janpieterbaalder/4d-rubiks-real/opstelling 4d rubiks real/README.md

# Opstelling 4D Rubiks — 3D werkbank + speelbare digital twin

`hardware.html` is de **enige ingang**: één realistische 3D-werkplaats met zowel de **hardware**
op (geschatte) ware grootte op een werkbank (een ESP32-DevKitC met een 74AHCT125-levelshifter op
een breadboard met de 330Ω, een draadloze controller, voeding, schakelaar, zekering,
verdeelblokken 5V/GND met de 1000µF, en de 189-WS2812B-led-rig) als de **speelbare game** op die 189
leds — 7 kubussen (midden + 6 armen) van elk 27 matwitte kubusjes met een led erin. Klik een
onderdeel aan voor uitleg + bedrading (de camera vliegt erheen), of speel direct (klik een kubusje /
controller-widget / toetsenbord). Aangestuurd door dezelfde, wiskundig geverifieerde engine als de
game.

Weergave (`bench/stage.js`): fysiek gebaseerde materialen, een studio-reflectiekaart, zachte
schaduwen, HDR-bloom op de leds, gekleurd licht dat de cellen op het frame en de werkbank werpen,
en Neutral-tone-mapping (houdt de 8 spelkleuren verzadigd). Schaal: 1 eenheid = 4 cm. Onder
**Weergave → Kwaliteit** schakel je tussen *hoog* en *laag* (voor telefoons/oudere laptops).

Zie [PLAN.md](PLAN.md) voor het volledige plan en [BEDRADING.md](BEDRADING.md) voor de
bouwhandleiding (BOM, pin-voor-pin, stroombudget, led-volgorde).

## Starten

De pagina gebruikt ES-modules + Three.js (van een CDN), dus serveer de map even
lokaal (dubbelklikken op `hardware.html` werkt niet vanwege module-beveiliging):

```powershell
cd "<pad-naar-de-repo>\opstelling 4d rubiks real"
python serve.py
# open daarna http://localhost:8000/hardware.html in Edge (of Chrome)
```

`serve.py` is een dev-server die caching uitschakelt, zodat wijzigingen altijd direct
zichtbaar zijn na verversen (gewone `python -m http.server` kan oude JS uit de cache tonen).

(Three.js komt nu van internet; voor een offline versie kunnen we het later lokaal meeleveren.)

## Besturing

Coördinaten (as-native, gelijk aan de fysieke led-plaatsing `ORIENT` en de firmware):
x = links(−)/rechts(+), y = onder(−)/boven(+), z = achter(−)/voor(+).
Kubus 0 in het midden (−1..1), de 6 armkubussen op ±3.

Speel met de **controller-widget** rechtsboven (1-op-1 met de echte draadloze controller), met
het **toetsenbord**, of klik direct een ledje aan.

| PS3-controller | Toetsenbord | Actie |
| --- | --- | --- |
| **D-pad** ▲▼◀▶ | `W`/`S`/`A`/`D` | Verplaats de selectie in het grondvlak (achter/voor/links/rechts) |
| **R-stick** ▲ / ▼ | `I` / `K` | Verplaats naar de boven- / onder-kubus |
| **L-stick** ◀ / ▶ | `←` / `→` | Draairichting (−/+); houd vast en kies een vlak |
| **□ / ✕ / ○ / △** | `Z` / `X` / `C` / `V` | Vlak XY / YZ / XZ / grip (ribbe 180° of hoek ±120°) |
| **L-stick ●** (L3) | `Enter` | 4D-rotatie (op de centrale cel van een armkubus) |
| **R-stick ●** (R3) | `Backspace` | Zet terug (undo) |
| **SELECT / START** | `Shift+S` / `Shift+R` | Husselen / reset |
| Slepen / scroll | | Camera draaien / verschuiven / zoomen |

**Niets beweegt mechanisch** — een rotatie verandert alleen de kleuren van de ledjes. Per cel
gelden exact de zetten uit het spel: de 3 vlakdraaien (`XY/YZ/XZ` ±90°, bij armkubussen met `W`),
plus bij randcellen een **180°-flip** en bij hoekcellen een **±120°-spin**. Centrale cellen kennen
alleen de 4D-rotatie. Een vlak "armeer" je met een face-knop en voer je uit met een richting (of
andersom) — net als op de echte controller.

> ℹ️ **Let op bij de grip (180°-flip / ±120°-spin):** je selecteert weliswaar een rand- of
> hoek-cubie, maar de zet **roteert de hele cel** (alle 27 ledjes van die kubus) om de bijbehorende
> ribbe- of lichaamsdiagonaal. Dat is geen los-blokje-draai maar een geldige celrotatie: ze ligt in
> de 24-elementen rotatiegroep van de kubus (geverifieerd in `game/test/math.test.js`). De
> geselecteerde cubie bepaalt enkel *welke* as.

### Oriëntatie: een getrouwe (niet-getaperde) kopie van de game
Elke kubus staat **exact georiënteerd zoals de game de bijbehorende cel projecteert**
(`engine.ORIENT`, afgeleid uit de 4D→3D-`project()` en in `engine.test.js` gecontroleerd
tegen die formules). Cruciaal: de interne **W-as** (binnen↔buiten) van elke armkubus loopt
*radiaal* — de `w=−1`-laag wijst naar het midden en is dus zichtbaar. (Een eerdere versie
knoopte W aan de diepte-as, waardoor een binnenste-cel-draai alleen verborgen achterlagen
veranderde en het leek alsof er niets gebeurde.) Hierdoor matcht elke draai van elke cel de
game. De Arduino moet de leds in deze oriëntatie bedraden.

### Hoe je een draai *ziet* zonder dat er iets beweegt
Een draai is een **permutatie**: elke kleur verhuist van een bron-led naar een doel-led, en
die verhuizingen vormen kleine kringetjes (4-cycli bij 90°, 3-cycli bij hoek-spins/8e-cel,
2-cycli bij rand-flips). De sim leest die permutatie uit (`engine.placements()` vóór/na de
zet) en laat een **heldere golf langs elk kringetje in de draairichting lopen**, terwijl elke
led naar zijn nieuwe kleur overvloeit zodra de golf passeert; leds die niet meedraaien dimmen
even weg (spotlight). Zo lees je de draai — óók op een effen opgeloste kubus, waar geen enkele
kleur verandert. Alles is pure led-kleur + helderheid over tijd, dus **1-op-1 na te maken op
de WS2812-leds** (de Arduino voert exact dezelfde golf uit).

## Bestanden

| Bestand | Doel |
| --- | --- |
| `engine.js` | Geverifieerde 4D-engine: twists, grips (180°/120°), centreren, `placements()`/`ledState()` (189-led-uitlezing + permutatie), `ORIENT` (kubus-oriëntatie = game-projectie) |
| `engine.test.js` | 28 controles die bewijzen dat de engine-port klopt, incl. ORIENT == game-projectie (`node engine.test.js`) |
| `hardware.html` + `hardware.js` | **De enige ingang**: interactieve 3D-werkbank (klik elk onderdeel voor uitleg + bedrading, gekleurde draadjes + stroom-/data-animatie) **én** de speelbare game op de 189 leds (controller-widget + toetsenbord). `CONNECTIONS` = de bedradingstabel (single source of truth) |
| `bench/stage.js` · `bench/parts.js` · `bench/textures.js` | De realistische scène: renderer + belichting + werkplaats + post-processing · de onderdelen-modellen op ware grootte · procedurele texturen (geen afbeeldingsbestanden nodig) |
| `tools/smoke.mjs` | Headless browsertest van de werkbank: start zonder fouten, alle verbindingen getekend, rendert, toetsenbord-spel (husselen/draaien/undo), infopaneel, weergaveknoppen, iPhone 15 Pro |
| `tools/bench-audit.mjs` | Exacte controles voor de smoke test: geen draad (mét dikte) door een onderdeel, het breadboard, de mat, het werkbankblad of de rig; elke ESP32-pin, 74AHCT125-poot en elk draadeinde in de juiste breadboard-strook |
| `firmware/test/parity.test.mjs` | Bewijst dat de C++-engine (`tesseract_engine.h`) exact gelijk rekent aan `engine.js` (native gecompileerd, duizenden willekeurige zetten) |
| `BEDRADING.md` | Bouwhandleiding: BOM, pin-voor-pin tabel, stroombudget, led-volgorde, bouw-/testvolgorde |
| `firmware/esp32_bluepad32/esp32_bluepad32.ino` | **Aanbevolen rig-firmware**: ESP32 + draadloze controller via **Bluepad32** (ingebouwde Bluetooth, geen shield/dongle) — zie `firmware/esp32_bluepad32/README-esp32.md` |
| `firmware/tesseract_rig.ino` | Alternatieve rig-firmware (Mega): leds + **PS3-controller (PS3BT via USB Host Shield)** + draai-animatie |
| `firmware/tesseract_engine.h` | De 4D-engine in C++ (1-op-1 port van `engine.js`) — single source of truth voor de wiskunde + de led-soldeerkaart + `freeRam()` |
| `firmware/wokwi/sketch.ino` | Wokwi-logica-testbank (PS3-layout nagebootst: 2 sticks + D-pad + face-knoppen + OLED): zelfde engine/leds/besturing, want Wokwi kan geen draadloze controller simuleren — zie `firmware/wokwi/README-wokwi.md` |
| `serve.py` | Dev-server zonder caching |
| `preview-*.png` | Referentiebeelden (opgelost / gehusseld) |

## Eén omgeving: hardware + spel in één scène

`hardware.html` combineert de bedrading-werkbank én de speelbare digital twin in dezelfde
3D-scène (draait onder `python serve.py`). Klik onderdelen aan om de bedrading te begrijpen, of
speel meteen op de 189 led-meshes. Zie **[BEDRADING.md](BEDRADING.md)** voor de volledige
hardware-handleiding. Voor browser-logica-tests van de firmware zonder hardware: de
Wokwi-testbank in [`firmware/wokwi/`](firmware/wokwi/).

## Tests draaien

```powershell
node engine.test.js                 # 28 checks: engine.js == de game-projectie
node firmware/test/parity.test.mjs  # C++-firmware-engine == engine.js (vereist g++ of clang++)
node tools/smoke.mjs                # 3D-werkbank in headless Chromium (vereist: npm i playwright)
```

De game-tests (`game/test/*.test.js`) vereisen `jsdom` (`npm i jsdom`). Alles draait ook
automatisch in GitHub Actions (`.github/workflows/tests.yml`) bij elke push en pull request.
