janpieterbaalder/4d-rubiks-real/opstelling 4d rubiks real/hardware.html

4D Rubiks — 3D-werkbank
werkplaats, onderdelen en 189 leds worden opgebouwd…

4D Rubiks · hardware & bedrading + speelbare game ℹ️ Over 📋 Bedrading 🎮 Game Status: AAN Cel: midden 0 zetten · opgelost ✔

×

×

## 4D Rubiks — over deze installatie

Een fysieke 4D-rubikskubus als licht-installatie · 189 WS2812B-leds in 7 kubussen

### Wat is dit?

Eén 3D-scène met zowel de echte hardware (een ESP32 met ingebouwde Bluetooth, een 3,3V→5V-levelshifter op de datalijn, een draadloze controller, 5V-voeding, 330Ω-weerstand, 1000µF-condensator, aan/uit-schakelaar, inline 10A-zekering, verdeelblokken 5V/GND) als de speelbare game op diezelfde 189 led-meshes. De 7 kubussen (midden + 6 armen, elk 3×3×3 = 27 matwitte kubusjes met een led erin) staan met staven verbonden op een rond voetstuk — net als het Blender-3D-model. Alles staat op (geschatte) ware grootte op een werkbank: kubusjes van ~2 cm, het geheel ~50 cm hoog.

Niets beweegt mechanisch. Een "draai" verplaatst geen plastic: alleen de kleuren van de ledjes verschuiven (de cellen permuteren wiskundig). Een tesseract heeft 8 cellen; je bouwt er fysiek 7 — de 8e ("buitenste") is verborgen. Met een 4D-rotatie op de centrale cel van een arm haal je verborgen cellen in beeld: die kubus wordt logisch het midden.

### Hoe je een draai ziet

Een draai is een permutatie: elke kleur verhuist van led naar led in kleine kringetjes (4-cycli bij 90°, 3-cycli bij hoek-spins, 2-cycli bij rand-flips). Er loopt een heldere golf in de draairichting langs zo'n kring terwijl elke led naar z'n nieuwe kleur overvloeit; de rest dimt even weg. Zo lees je de draai af — óók op een effen opgeloste kubus. Puur led-kleur + helderheid, dus 1-op-1 na te maken op de echte WS2812-leds.

### Spelen

- Bewegen: D-pad / WASD (grondvlak) · R-stick ▲▼ / IK (boven/onder-kubus)
- Draaien: houd een richting (L-stick ◀▶ / ←→) en kies een vlak Z/X/C/V (XY/YZ/XZ/grip) — of andersom
- 4D-rotatie L3 / Enter · undo R3 / ⌫ · husselen SELECT / Shift+S · reset START / Shift+R
- Of klik een onderdeel aan voor uitleg + bedrading, of een ledje om een cel te kiezen. Sleep/scroll = camera.

### De hardware

Klik links op een onderdeel om te zien wat het is en hoe het is aangesloten (de gekleurde draden lichten dan op). De besturing is een draadloze controller (PS4/PS5/Xbox/8BitDo/Switch Pro, of een DS3) via de ingebouwde Bluetooth van de ESP32 (bibliotheek Bluepad32) — geen shield of dongle. De 189 leds hangen aan één datadraad (GPIO13, via een levelshifter + 330Ω) uit een aparte 5V-voeding met power-injectie. De volledige bouwhandleiding — onderdelenlijst, pin-voor-pin bedrading, stroombudget en led-volgorde — staat in de 📋 Bedrading-pagina (gerenderd uit BEDRADING.md).

### Firmware & testen zonder hardware

De geverifieerde 4D-engine draait 1-op-1 op de microcontroller (firmware/; aanbevolen: esp32_bluepad32/). Geen hardware bij de hand? In Wokwi draai je de échte ESP32-code tegen gesimuleerde WS2812-leds in de browser — de logica-testbank firmware/wokwi_esp32/sketch.ino (controller nagebootst met sticks + knoppen, want Wokwi kan geen draadloze controller simuleren) test de engine én de 189-led-adressering. Dat de C++-engine exact hetzelfde rekent als deze 3D-twin, bewijst firmware/test/parity.test.mjs. Open de Wokwi-testbank ↗ (https://wokwi.com/projects/467721462500426753)

### Links

- Bouwhandleiding & bedrading: 📋 Bedrading-pagina openen (gerenderd uit BEDRADING.md)
- Broncode: github.com/janpieterbaalder/4d-rubiks-real
- De originele 4D-game (meegeleverd in deze omgeving): spelen — via de tab 🎮 Game bovenin
- Wokwi-firmwaresimulatie (ESP32-testbank): de testbank draaien ↗ (https://wokwi.com/projects/467721462500426753)

Sleep = draaien · scrollwiel indrukken / rechts slepen = verschuiven · scroll = zoomen · klik een onderdeel (de camera vliegt erheen) · speel met de controller of toetsenbord (WASD/IK = bewegen, ←/→ + Z/X/C/V = draaien)

Onderdelen ▸

Weergave ▸

⚡ Stroom-animatie 🏷 Labels 🧵 Led-draad 📡 Stuur dataframe 👁 Reset camera 🎚 Kwaliteit

Zo speel je ▸

Bewegen — D-pad / WASD = grondvlak · R-stick / I·K = op/neer

Draaivlak — face-knoppen of Z X C V

Draairichting — L-stick ◄► of ← →

4D-rotatie — ● L-stick of Enter

Zet terug — ● R-stick of Backspace

Husselen / Reset — SELECT·⇧S / START·⇧R

Draden ▸

Acties 🧭 Reset 4D-zicht ⏻ Aan / Uit

▲ ◀ ▶ ▼

beweeg x,y · WASD

SELECT
husselen START
reset

V— ZXY CXZ XYZ

vlak kiezen + richting

◀ ●
4D ▶

draairichting ←/→ · ● = 4D (Enter)

▲ ●
undo ▼

omhoog/omlaag I/K · ● = undo (⌫)
