janpieterbaalder/4d-rubiks-real/4d rubiks 3d model/blender_renders/connectors_v2.png

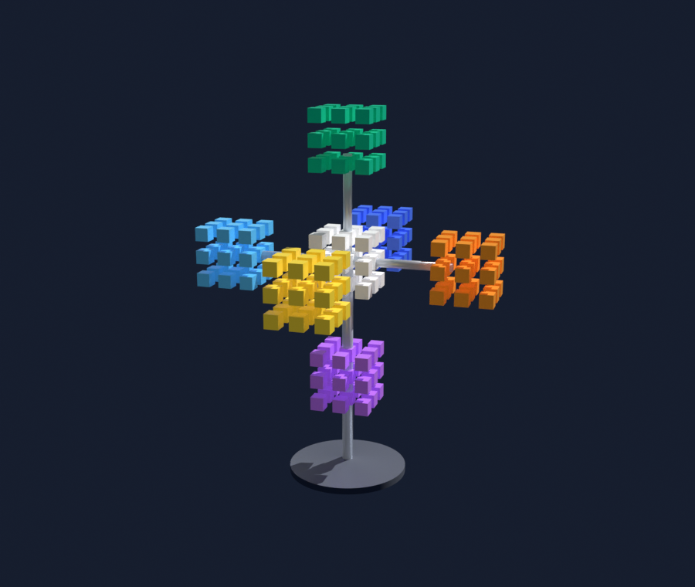
4d rubiks 3d model/blender_renders/connectors_v2.png
