janpieterbaalder/4d-rubiks-real/4d rubiks 3d model/blender_renders/tesseract_v5.png

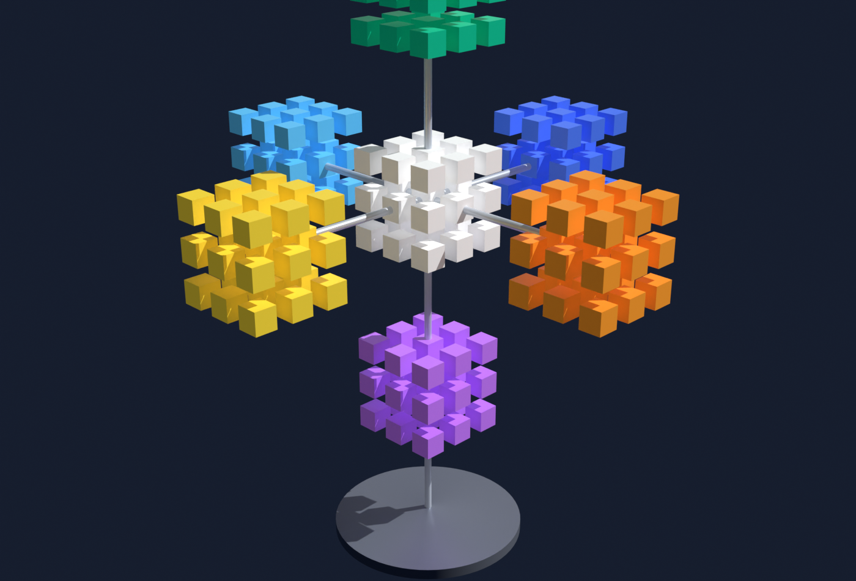
4d rubiks 3d model/blender_renders/tesseract_v5.png
