janpieterbaalder/4d-rubiks-real/opstelling 4d rubiks real/preview-gehusseld.png

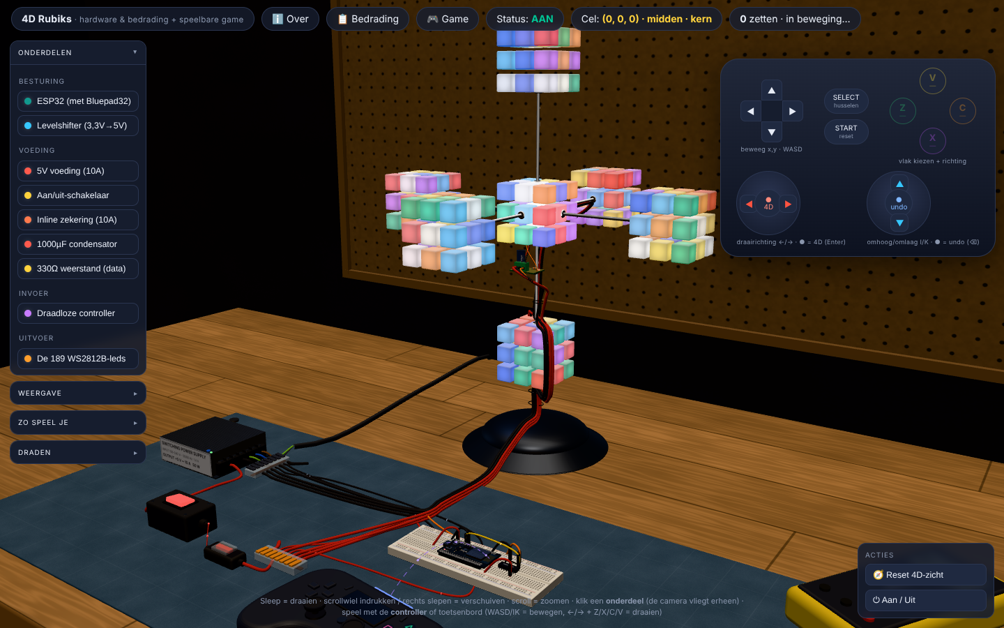
opstelling 4d rubiks real/preview-gehusseld.png
