janpieterbaalder/4d-rubiks-real/playstation controller/playstation controller besturing.png

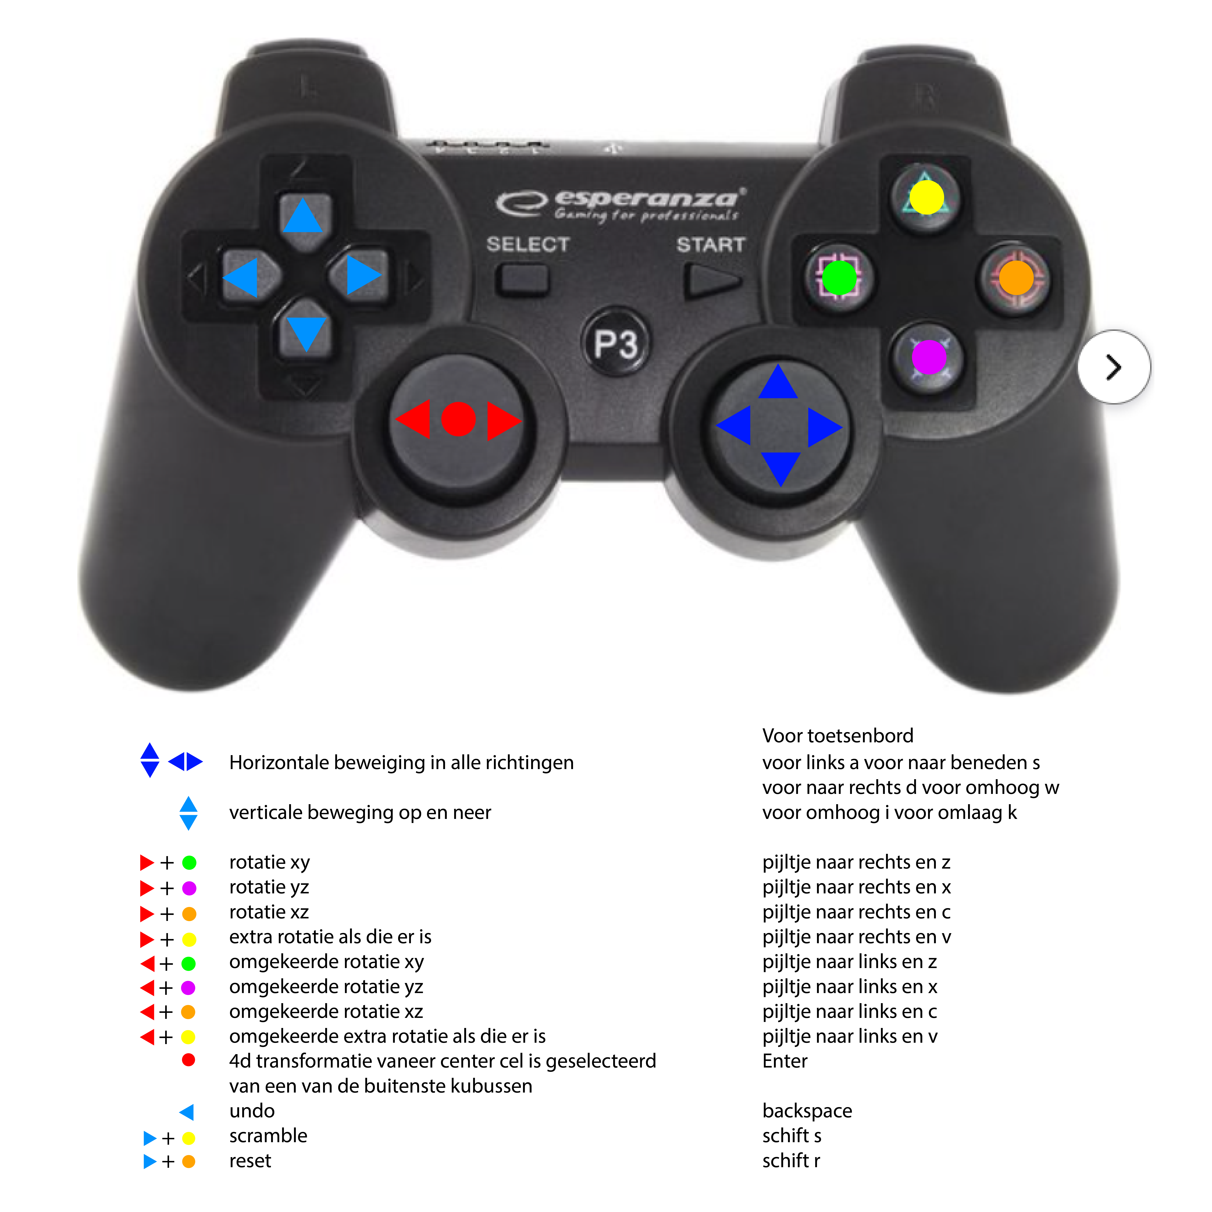
playstation controller/playstation controller besturing.png
