janpieterbaalder/4d-rubiks-real/(list of files, cad)

Other CAD files:
4d rubiks 3d model/4d rubiks 3d model.blend
