janpieterbaalder/4d-rubiks-real/(commit log)

2026-06-22 4D Rubiks LED-installatie: 3D-werkbank, PS3BT-firmware, bedrading en Blender-model
    - opstelling 4d rubiks real: hardware.html/js (3D-bench + speelbare twin op 189 leds),
    engine.js (+ 28 tests), firmware/tesseract_rig.ino (PS3BT) + tesseract_engine.h,
    BEDRADING.md, en de Wokwi-logica-testbank (firmware/wokwi/).
    - 4d rubiks 3d model: Blender-model (7 kubussen + verbindingsstaafjes + staander met
    ronde voet) en renders.
    - playstation controller: ontwerp-asset van de bediening.
    - hardware.html heeft een tab naar de online game (GitHub Pages).
    De originele Tesseract-game staat in een eigen repo (janpieterbaalder/tesseract-4d-rubiks-cube),
    gelinkt via de 'Online game'-tab; daarom hier niet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
    [4d rubiks 3d model.blend]
2026-06-23 Live 3D-omgeving op GitHub Pages + 'Over'-tab
    - root index.html: redirect naar de 3D-werkbank (opstelling .../hardware.html)
    - .nojekyll: Pages serveert de bestanden ongemoeid (mappen met spaties)
    - hardware.html: nieuwe 'ℹ️ Over'-tab met een uitleg-overlay (wat het is, besturing,
    hardware, links naar repo + online game) — voor live-bezoekers naast de README
2026-06-23 3D-omgeving: kubussen verbonden met staven + rond voetstuk; Over-tab uitgebreid
    - hardware.js: 6 verbindingsstaven (midden -> elke armkubus) + een pool die in een
    ronde voet (flared disc + domed top) uitkomt, zoals het Blender-model. Cache v=5.
    - hardware.html: 'ℹ️ Over'-overlay uitgebreid (wat is dit / 8e-cel-4D, hoe je een draai
    ziet, spelen, hardware, firmware + Wokwi-testbank) en een Wokwi-link toegevoegd.
2026-06-23 3D-omgeving: ook de pool van de voet naar de onderste kubus half zo dun (0.13 -> 0.065); cache v=7
2026-06-23 Game als code meegeleverd in de repo (niet langer een externe link)
    - opstelling 4d rubiks real/game/: de complete, speelbare 4D-Rubiks-game (Tesseract)
    gekopieerd uit de tesseract-4d-rubiks-cube-repo (index.html/app.js/styles.css/README/test).
    - hardware.html: de '🎮 Game'-tab opent nu de meegeleverde game (game/index.html) in
    dezelfde omgeving i.p.v. een externe Pages-link; Over-tab + README + .gitignore bijgewerkt.
2026-06-23 Game: '⟵ 3D-omgeving'-terugknop toegevoegd (terug naar hardware.html)
2026-06-23 Wokwi gelijk aan de rig + ESP32/Bluepad32-firmware + analysepunten (#1)
    * Wokwi gelijkgetrokken met de rig + analysepunten verwerkt
    Verbeterpunten uit de analyse aangepast (niets aan de geverifieerde
    engine/wiskunde gewijzigd; engine.test.js blijft 28/28 groen):
    - Wokwi-testbank op as-native navigatie + "vlak armeren + richting"-model
    (firmware/wokwi/sketch.ino + diagram.json): het oude 3-joystick/scroll-menu
    is vervangen door een nagebootste PS3-layout (2 sticks + D-pad + 4
    face-knoppen + SELECT/START). Navigatie, mapping en draaimodel zijn nu
    identiek aan tesseract_rig.ino en hardware.html; alleen de led-data was al
    gelijk. Stick-leeslogica vereenvoudigd (level/edge), OLED-HUD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
2026-06-23 3D-werkbank omgebouwd naar de ESP32 + Bluepad32-opstelling (#2)
    De 3D-scène (hardware.html + hardware.js) toonde nog de Arduino Mega + USB
    Host Shield + Bluetooth-dongle, terwijl de docs de ESP32 + Bluepad32 als
    aanbevolen build hebben. Die mismatch is nu weg:
    - Mega-bordje vervangen door een ESP32 (met metalen RF-can + PCB-antenne voor
    de ingebouwde Bluetooth).
    - USB Host Shield + BT-dongle verwijderd; een 3,3V->5V-levelshifter (74AHCT125)
    toegevoegd in de datalijn: ESP32 GPIO13 -> levelshifter -> 330Ohm -> DIN.
    - CONNECTIONS-tabel, info-kaartjes, MENU, dradenlegenda en de "Over"-teksten
    lopen nu gelijk met de ESP32-firmware. De draadloze controller praat
    rechtstreeks met de ESP32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
2026-06-24 ESP32-Wokwi-testbank toegevoegd (firmware/wokwi_esp32)
    ESP32-port van de logica-testbank: draait dezelfde tesseract_engine.h + besturing
    als de echte draadloze firmware (esp32_bluepad32), maar op een gesimuleerde ESP32.
    Wokwi kan geen Bluetooth, dus de gamepad wordt nagebootst met 2 sticks + D-pad +
    4 face-knoppen + SELECT/START — mapping 1-op-1 gelijk aan esp32_bluepad32 + hardware.html.
    - sketch.ino: ESP32-pinmap (ADC1-sticks 34/35, knoppen op pull-up-pinnen, LED op 23),
    analogReadResolution(10) (ADC 0..1023 als de AVR-rig), esp_random() als husselseed,
    Wire.begin(21,22) voor I2C, heap-print i.p.v. AVR freeRam. PadButton-naam +
    forward-declaratie tegen FastLED's fl::Button en Ardu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
2026-06-24 ESP32-testbank: FastLED gepind op @3.7.8 (Wokwi-build werkt nu)
    In Wokwi gebleken: 3.6.0 is te oud voor de huidige ESP32-core (IDF5/arduino-esp32 3.x)
    -> "'RMTMEM' was not declared". De nieuwste FastLED (3.9.x) laat cc1plus juist
    out-of-memory gaan op Wokwi's gratis 2GB-buildserver. 3.7.8 heeft de RMT5-driver en is
    licht genoeg: compileert schoon en draait stabiel op de gesimuleerde ESP32.
2026-06-25 Mega Wokwi-testbank: compile-fixes tegen huidige Wokwi/FastLED
    De Mega-testbank (firmware/wokwi) compileerde niet meer schoon op de actuele Wokwi/FastLED:
    - FastLED 3.9 introduceert een globale fl::Button die botst met de struct Button in de sketch
    -> hernoemd naar PadButton.
    - Arduino's auto-prototype-generator zet de prototype van pressed(PadButton&) bovenaan, voor de
    struct-definitie -> forward-declaratie 'struct PadButton;' toegevoegd voor de eerste functie.
    - libraries.txt: FastLED gepind op @3.7.8 (3.9 laat cc1plus out-of-memory gaan op Wokwi's gratis
    2GB-buildserver; 3.7.8 is licht genoeg). Zelfde fix als de ESP32-testbank.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
    [sketch.ino]
2026-06-25 BEDRADING ESP32-only + Wokwi LED-data naar GPIO13 (gelijk aan de bouw)
    Fix 1: BEDRADING.md volledig herschreven naar de ESP32 + Bluepad32-bouw.
    - Mega / USB Host Shield / BT-dongle verwijderd (ESP32 is de enige bouw).
    - Echte ESP32 pin-voor-pin tabel (GPIO13 -> 74AHCT125 -> 330ohm -> DIN),
    voeding via 5V/VIN, gedeelde GND.
    - Voedingsgetal rechtgetrokken: capped build = 5V/10A overal (ASCII-schema
    zei eerder >=6A); 6A is het firmware-doel, niet de voedingsrating.
    - Stale voettekst herschreven (was "USB Host Shield + PS3BT, data pin 6").
    - Wokwi-link naar de actuele ESP32-testbank (467721462500426753).
    Fix 2: Wokwi-ESP32-testbank LED-data van GPIO23 -> GPIO13, gelijk aan de
    bouw-firmware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
    [sketch.ino]
2026-06-25 Site: BEDRADING als pagina (bedrading.html) + Wokwi-link bijgewerkt
    - Nieuw: opstelling 4d rubiks real/bedrading.html — rendert BEDRADING.md live
    in de browser (marked via unpkg, met fallback naar GitHub/ruw bestand als de
    CDN of fetch faalt). Dark-thema gelijk aan hardware.html; topbar met terug-link,
    Wokwi- en GitHub-link. BEDRADING.md blijft de single source of truth.
    - hardware.html: nieuwe tab "📋 Bedrading" -> bedrading.html; in de tekst is
    BEDRADING.md nu een klikbare link naar die pagina.
    - hardware.html: Wokwi-verwijzing bijgewerkt van het oude Mega-project
    (467182062676747265) naar de actuele ESP32-testbank (467721462500426753), en
    het firmware-pad firmware/wokwi/ -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
2026-07-17 Werkbank: inline zekering als klikbaar onderdeel + info-kaartjes gelijk met BEDRADING (#3)
    Zekering (glaspatroon in houder) als klikbaar 3D-onderdeel tussen schakelaar
    en 5V-vertakking; CONNECTIONS + BEDRADING §2-pintabel gelijk aan het §3-schema;
    info-kaartjes bijgewerkt (condensator 10-16V, voeding capped build 5V/10A,
    schakelaar 10A/15A, ESP32 i.p.v. Mega-restteksten); cache v=10.
    Claude-Session: https://claude.ai/code/session_019xEiPQsLXAxy5g8XS8cgs1
2026-10-07 Analyse + realistische 3D-werkplaats; undo-bug firmware, injectie L/D/B, tests + CI (#4)
    - 3D-werkbank realistisch: PBR, schaduwen, bloom, gekleurd led-licht, Neutral-tone-mapping (three.js r165), werkplaats, onderdelen op ware grootte, led-rig als 7 x 27 matte kubusjes (InstancedMesh), kabelboom dóór de kubussen, ingangsprintje met 330R + 1000uF bij led #0; framerate-onafhankelijke animatie en diverse werkbank-fixes.
    - Firmware: undo-historie als ringbuffer (stopte bij 16 zetten met opnemen); één zet tegelijk + statusmelding in esp32_bluepad32 en wokwi_esp32.
    - Power-injectie L/D/B (#54/#108/#162) i.p.v. R/U/B (gat van 81 leds).
    - Tests: C++/JS-pariteitstest, headless smoke-test, GitHub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
    [esp32_bluepad32.ino, hardware.js, sketch.ino, tesseract_engine.h]
2026-10-07 Mobiel: werkbank, bedrading en game bruikbaar op iPhone 15 Pro (#5)
    - hardware.html: op telefoons (≤760px breed of ≤500px hoog) een dock onderin
    (Menu / Besturing / 4D-zicht / Aan-uit); onderdelenmenu, controller en
    infopaneel worden panelen die het dock één tegelijk opent. Compacte
    topbalk, safe-area-insets (viewport-fit=cover), landschap met controller
    op één rij en panelen rechts.
    - hardware.js: startcamera stapt terug op smalle schermen, focus houdt
    rekening met de horizontale beeldhoek, labels standaard uit op telefoon,
    pinch/twee-vinger-pan telt niet als tik, en het beeld schuift onder een
    open paneel vandaan (setViewOffset; draaipunt blijft gelijk).
    - bedrading.h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
2026-10-07 Game-topbalk past op smalle telefoons; smoke test eist 8px marge (#6)
    De Time/Moves-teller eindigde op 393px precies op de schermrand en viel op
    375/360px erbuiten; in CI (andere fontmetriek) faalde daardoor de
    iPhone-portret-check. Onder 430px verdwijnt nu het woordmerk naast het logo.
    De smoke test eist voortaan 8px marge tot de rand en controleert ook 375 en
    360px breed.
    Claude-Session: https://claude.ai/code/session_01XWFjAKb31JpPkJFKiaVHo8
2026-10-08 Werkbank: prototype-opstelling i.p.v. ingangsprintje (330Ω op breadboard, 1000µF in verdeelblokken) (#7)
    - Ingangsprintje van de rig gehaald; de kabelboom brengt 5V, GND en DATA rechtstreeks naar led #0.
    - 330Ω op het breadboard direct achter de 74AHCT125 (poot in de kolom van 1Y, geen extra draadje).
    - 1000µF in de nieuwe verdeelblokken 5V/GND (GND-sterpunt naast het 5V-blok); bewust niet op het
    breadboard, want daar loopt de led-stroom niet (breadboards ~1A per contact).
    - Exacte draad-audit (tools/bench-audit.mjs, in de smoke test): geen draad (mét dikte) meer door
    onderdelen, breadboard, mat, werkbankblad of rig-staven; elke ESP32-DevKitC V4-pin, 74AHCT125-poot
    en elk draadein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
2026-10-08 Werkbank: geen draad door draad, levelshifter-ingangen vast + chip-opdruk goed om, menu's scrollen (#8)
    - Kabelboom: aftakkingen als plat lint (draden naast elkaar, haaks op de looprichting), nieuwe
    slotindeling + verdeelblok-volgorde; ontwarstap separateWires duwt resterende contacten uit elkaar
    (uiteinden vast, niets door mat/werkbank/rig-frame); kabelbinders om de werkelijke draden.
    - 74AHCT125: zes draadbruggen leggen de ongebruikte ingangen vast (2OE + 2A aan GND, 3OE/3A/4OE/4A
    aan 5V); opdruk zoals op een echte DIP met de inkeping rechts, inkeping en pin-1-stip zichtbaar.
    - Menu's: linkermenu scrolt i.p.v. afknippen, × van info/Over sticky, op de telefoon één sheet
    tegelijk,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
